senamhi-bolivia/AcroBoard_Station_GPRS_V04R04_XTAL/AcroBoard_Station_GPRS_V04R04_XTAL.kicad_pcb

## KiCad design AcroBoard_Station_GPRS_V04R04_XTAL.kicad_pcb (2019-05-08)

Schematic: AcroBoard_Station_GPRS_V04R04_XTAL.sch, AcroBoard Station v04 - electronic schematic

Parts:
C1, C2, C4, C7, C10, C11, C12, C14, C22, C25, C34, C77, C78, C79, C80, C81, C82: 100nF; C_0603
C3, C16, C17: 1uF; C_0805
C5, C6, C8, C9, C20, C23, C24, C28, C35, C36, C39, C43, C44, C47, C48, C59, C62: 100nF; C_0402_NoSilk
C13: 68uF; CP_Tantalum_Case-D_EIA-7343-31_Reflow
C15, C19, C21: 22pF; C_0402_NoSilk
C18: 68uF; CP_Elec_5x5.8
C26: 470uF; CP_Radial_D10.0mm_P5.00mm
C27: 22uF; C_0805
C29, C30: 1nF; C_0402
C31, C37, C49, C51: 7pF; C_0402_NoSilk
C32, C38, C40: 33pF; C_0402_NoSilk
C33, C45, C46, C52, C53, C63: 4.7uF; C_0805
C41, C42: 22uF; C_1210
C50: 10uF; C_0805
C54, C55, C65, C66: 22uF; C_1206
C56: 330uF; CP_Elec_10x10
C57, C64, C69: 6.8nF; C_0603
C58, C72: 10uF; C_1210
C60, C61, C70, C71, C74, C75: 0.1uF; C_0805
C67: 4.7uF; CP_Elec_4x5.8
C68: 1uF; C_1206
C73: 100uF; CP_Elec_6.3x7.7
C76: 10uF; C_1206
Cv1, Cv2, Cv3: 0.1uF; C_0805
Cvs1, Cvs2, Cvs3: 1uF; C_0805
D1: Blue; LED_0603
D2, D3, D19: Green; LED_0603
D4, D9, D11, D14: SMBJ26CA; D_SMB
D5, D6, D12, D15: 1N4148W-V; D_SOD-123
D7: BZX84C10; SOT-23
D8, D18: STPS2L40U; D_SMB
D10, D13, D16: BAT54JFILM; D_SOD-323
D17: STPS3L40SY; D_SMC
D20: Red; LED_0603
FP1: {55.0,-148.0}; Fiducial_1mm_Dia_2.54mm_Outer_CopperTop
FP2: {55.0,-30.0}; Fiducial_1mm_Dia_2.54mm_Outer_CopperTop
FP3: {125.0,-148.0}; Fiducial_1mm_Dia_2.54mm_Outer_CopperTop
FP4: {125.0,-30.0}; Fiducial_1mm_Dia_2.54mm_Outer_CopperTop
FP5: {84.6,-79.9}; Fiducial_1mm_Dia_2.54mm_Outer_CopperTop
FP6: {90.0,-115.0}; Fiducial_1mm_Dia_2.54mm_Outer_CopperTop
FP7: {116.0,-89.0}; Fiducial_1mm_Dia_2.54mm_Outer_CopperTop
J1: Conn_Coaxial; SMA_THT_Jack_Straight
J2: Conn_01x08; Molex_KK-6410-08_08x2.54mm_Straight
J3: Conn_01x05; Molex_KK-6410-05_05x2.54mm_Straight
J4, J5: CONN_01X10; Molex_KK-6410-10_10x2.54mm_Straight
J6: CONN_01X08; Molex_KK-6410-08_08x2.54mm_Straight
J7: CONN_01X05; Molex_KK-6410-05_05x2.54mm_Straight
L1, L2, L3: FERRITE-BEAD-220ohm; L_0805
L4: INDUCTOR-3.1uH; SER80xx
L5: 10uH; 7447779122
LG1: ACRONET; ACRONET_logo_090
LG2: OSHW; OSHW-Logo_7.5x8mm_SilkScreen
MH1, MH2, MH3, MH4: MH; MountingHole_320_500-NPTH
P1: CONN_02X06; Socket_Strip_Straight_2x06_Pitch2.54mm_SMD
P2: CONN_14X2; Socket_Strip_Straight_2x14_Pitch2.00mm
P3: 10k B=3.380; Measurement_Point_Round-TH_Small
P4: CONN_5X2; Socket_Strip_Straight_2x05_Pitch2.00mm
P5: CONN_5; BM05B-SRSS-TB
P6: CONN_3; Molex_KK-6410-03_03x2.54mm_Straight
Q4: Si2319CDS; SOT-23
Q5, Q9, Q10: BSS138; SOT-23
Q6, Q7, Q8: IRF9362; SOIC-8_3.9x4.9mm_Pitch1.27mm
R1, R2, R65, R66: 4k7; R_0603
R3, R4, R5, R56, R62, R63, R64, R67: 330R; R_0603
R6, R7, R8: 51R; R_0402
R9, R22, R45, R55, R68: 100K; R_0603
R10: 90k; R_0603
R11, R18, R19, R29, R54: 10K; R_0603
R12: 24K; R_0603
R13, R17, R71, R72, R73, R75, R76, R78: 1K; R_0603
R14: 180K; R_0603
R15: 698K; R_0603
R16, R51: 174K; R_0603
R20, R36, R39, R40, R46, R47: 1M; R_0603
R21, R44: 215K; R_0603
R23, R30: 1M02; R_0805
R24, R69: 48K7; R_0805
R25, R32: 76K8; R_0805
R26: 698K; R_0805
R27: 27K; R_0805
R28: 49K9; R_0805
R31: 36K5; R_0805
R33: 0R; R_0805
R34, R35, R49, R50, R53, R79, R80, R81, R82: 309K; R_0603
R37: 73.2K; R_0603
R38, R41, R48: 2k21; R_0603
R42, R43: 1k3; R_0805
R52: 4K7; R_0603
R57: 0R05; R_1206
R58, R61: 5K1; R_0603
R59, R60: 2k0; R_0805
R70, R74, R77: 5K6; R_0603
SW1: DTSM-32S-B
T1, T2, T3, T4, T5, T6, T7, T8, T9, T10: PDTC143XU; SOT-323_SC-70
U1, U2, U3: AT24CM01-SSHD-B; SOIC-8_3.9x4.9mm_Pitch1.27mm
U4: MB85RC1MTPNF-G-JNERE1; SOIC-8_3.9x4.9mm_Pitch1.27mm
U5, U6: SP336EEY-L; TSSOP-28_4.4x9.7mm_Pitch0.65mm
U7: 78723-1001
U8: ESDA6V1-5W6; SOT363_ESDA6V1-5W6
U9: NCP3170; SOIC-8_3.9x4.9mm_Pitch1.27mm
U10: TPS737; SOT-223-6
U11: ATXMEGA256A3U; TQFP-64_14x14mm_Pitch0.8mm
U13: SIM800C; SIMCom_SIM800C
U14: LTC4417IGN; SSOP-24_3.9x8.7mm_Pitch0.635mm
U15, U16, U21, U22: FPF2701MX; SOP-8_FPF2701MX
U17: LT3652EMSE; MSOP12_LT3652EMSE_HandSoldering
U18, U19: ACPL-M21L; SO-5_ACPL-M21L
U20: MIC1555; SOT-23-5
U23: PCA9517ADP; TSSOP-8_3x3mm_Pitch0.65mm
U24: MPL3115A2; LGA-8_3x5mm_Pitch1.25mm
U25: PCAL9554B; TSSOP-16_4.4x5mm_Pitch0.65mm
U26: PCAL9535APW; TSSOP-24_4.4x7.8mm_Pitch0.65mm
Y1: Crystal; Crystal_SMD_MicroCrystal_CC7V-T1A-2pin_3.2x1.5mm

Connections:
/ALT_CHARGE: J3.2, Q10.3 (D), R58.2
/BC_NC_FET: D7.1 (A), Q4.1 (G), R19.1, R22.2
/BC_NTC: P3.1, U17.8 (NTC)
/BC_Timer: C53.2, U17.6 (TIMER)
/BC_Vin: C56.1, C58.1, C59.1, D7.3 (K), D8.1 (K), D19.2 (A), D20.2 (A), J3.5, Q4.2 (S), R22.1, R36.2, R40.2, U17.1 (Vin)
/CLED_CMD: Q5.3 (D), Q10.1 (G), R37.1
/CMD_PSW1: R79.1, U16.4 (ON), U26.16 (P1_3)
/CMD_PSW2: R80.1, U15.4 (ON), U26.15 (P1_2)
/CMD_PSW3: R82.1, U22.4 (ON), U26.14 (P1_1)
/CMD_PSW4: R81.1, U21.4 (ON), U26.13 (P1_0)
/I2C_OUT_SCL: P4.3, U23.2 (SCLA)
/I2C_OUT_SDA: P4.1, U23.3 (SDAA)
/I2C_SIG: P4.7, T3.3 (C)
/I2C_VIN: C79.2, P4.5, U23.1 (VCCA)
/MCU_Status_LED: T1.1 (B), U11.26 (PD0)
/NETLIGHT: T9.1 (B), U13.41 (NETLIGHT)
/NValid1: U14.10 (~VALID1), U26.6 (P0_2)
/NValid2: U14.11 (~VALID2), U26.5 (P0_1)
/NValid3: U14.12 (~VALID3), U26.4 (P0_0)
/N_SHDN: R18.1, U14.2 (~SHDN)
/OC1: J7.2, R62.2
/OC2: J7.3, R63.2
/OC3: J7.4, R64.2
/OC4: J7.5, R67.2
/PA0: C34.1, P2.1, U11.62 (PA0)
/PA1: R10.2, R11.1, U11.63 (PA1)
/PA2: P2.3, U11.64 (PA2)
/PA3: P2.5, U11.1 (PA3)
/PA4: P2.7, U11.2 (PA4)
/PA5: P2.9, U11.3 (PA5)
/PA6: P2.11, U11.4 (PA6)
/PA7: P2.13, U11.5 (PA7)
/PB0: C35.1, P2.15, U11.6 (PB0)
/PB1: P2.17, U11.7 (PB1)
/PB2: P2.19, U11.8 (PB2)
/PB3: P2.21, U11.9 (PB3)
/PB4: P2.23, U11.10 (PB4)
/PB5: P2.25, U11.11 (PB5)
/PB6: P2.27, U11.12 (PB6)
/PB7: U11.13 (PB7), U23.5 (EN)
/PC0: R66.2, U11.16 (PC0), U23.6 (SDAB)
/PC1: R65.2, U11.17 (PC1), U23.7 (SCLB)
/PC2: U5.19 (R1_Out), U11.18 (PC2)
/PC3: U5.26 (TI_In), U11.19 (PC3)
/PC4: U5.27 (T2_In), U11.20 (PC4)
/PC5: U5.1 (T4_In), U11.21 (PC5)
/PC6: U5.21 (R3_Out), U11.22 (PC6)
/PC7: U5.28 (T3_In), U11.23 (PC7)
/PCAL_P3: T5.1 (B), U26.7 (P0_3)
/PCAL_P4: T6.1 (B), U26.8 (P0_4)
/PCAL_P5: T7.1 (B), U26.9 (P0_5)
/PCAL_P6: T8.1 (B), U26.10 (P0_6)
/PCAL_P7: T4.1 (B), U26.11 (P0_7)
/PD1: T3.1 (B), U11.27 (PD1)
/PD2: U6.19 (R1_Out), U11.28 (PD2)
/PD3: U6.26 (TI_In), U11.29 (PD3)
/PD4: U6.27 (T2_In), U11.30 (PD4)
/PD5: U6.1 (T4_In), U11.31 (PD5)
/PD6: U6.21 (R3_Out), U11.32 (PD6)
/PD7: U6.28 (T3_In), U11.33 (PD7)
/PDI_CLK: P1.4, R29.1, U11.57 (~RESET)
/PDI_DATA: P1.6, U11.56 (PDI)
/PE0: R1.2, U1.5 (SDA), U2.5 (SDA), U3.5 (SDA), U4.5 (SDA), U11.36 (PE0), U24.7 (SDL), U25.15 (SDA), U26.23 (SDA)
/PE1: R2.2, U1.6 (SCL), U2.6 (SCL), U3.6 (SCL), U4.6 (SCL), U11.37 (PE1), U24.8 (SCL), U25.14 (SCL), U26.22 (SCL)
/PF3: T2.1 (B), U11.49 (PF3)
/PF4: T10.1 (B), U11.50 (PF4)
/PF6: P1.10, U11.54 (PF6)
/PF7: P1.8, U11.55 (PF7)
/PG: R68.2, R69.1, U9.7 (PG), U10.5 (EN)
/PR0: U11.58 (PR0), U18.5 (VO)
/PR1: U11.59 (PR1), U19.5 (VO)
/PSW1: C61.1, J6.1, U16.8 (VOUT)
/PSW2: C60.1, J6.3, U15.8 (VOUT)
/PSW3: C75.1, J6.5, U22.8 (VOUT)
/PSW4: C74.1, J6.7, U21.8 (VOUT)
/PULSE1: P6.3, R43.1
/PULSE2: P6.1, R42.1
/PWRKEY: C24.1, T2.3 (C), U13.39 (~PWRKEY)
/Panel+: D4.1 (A1), D8.2 (A), J3.4, Q4.3 (D)
/RF_ANT: J1.1 (In), U13.32 (GSM_ANT)
/RING_TO_SIM: R71.1, U13.7 (UART1_RI)
/RX1: J4.2, U5.15 (R1_In)
/RX2: J4.3, U5.16 (R2_In)
/RX2_1: J5.2, U6.15 (R1_In)
/RX2_2: J5.3, U6.16 (R2_In)
/RX2_3: J5.7, U6.17 (R3_In)
/RX2_4: J5.8, U6.18 (R4_In)
/RX3: J4.7, U5.17 (R3_In)
/RX4: J4.8, U5.18 (R4_In)
/S900CTS: R72.2, U11.41 (PE5)
/S900RI: R71.2, U11.46 (PF0)
/S900STATUS: R78.1, U11.47 (PF1)
/SIMCTS_TO_SIM: R72.1, U13.4 (UART1_CTS)
/SIM_CLK: C19.1, R7.2, U13.16 (SIM_CLK)
/SIM_CLK_0: R7.1, U7.3 (CLK), U8.1 (I/O1)
/SIM_DATA: C15.1, R6.2, U13.15 (SIM_DATA)
/SIM_DATA_0: R6.1, U7.7 (I/O), U8.6 (I/O4)
/SIM_RST: C21.1, R8.1, U13.17 (SIM_RST)
/SIM_RST_0: R8.2, U7.2 (RST), U8.3 (I/O2)
/SIM_RXD: R76.1, R77.2, U13.2 (UART1_RXD)
/SIM_TXD: R75.1, U13.1 (UART1_TXD)
/SIM_USB_DM: P5.4, U13.26 (USB_DM)
/SIM_USB_DP: P5.3, U13.25 (USB_DP)
/SIM_USB_VBUS: P5.1, U13.24 (USB_VBUS)
/SIM_VDD: C23.1, U7.1 (Vcc), U8.4 (I/O3), U13.18 (SIM_VDD)
/SIM_VDDEXT: U13.40 (VDD_EXT)
/SP336_2_M0: U6.24 (MODE_0), U25.6 (P2)
/SP336_2_M1: U6.2 (MODE_1), U25.4 (P0)
/SP336_2_M2: U6.23 (MODE_2), U25.5 (P1)
/SP336_2_SLEW: U6.25 (SLEW), U25.7 (P3)
/SP336_M0: U5.24 (MODE_0), U25.10 (P5)
/SP336_M1: U5.2 (MODE_1), U25.12 (P7)
/SP336_M2: U5.23 (MODE_2), U25.11 (P6)
/SP336_SLEW: U5.25 (SLEW), U25.9 (P4)
/STATUS_PSW1: U16.7 (FLAGB), U26.20 (P1_7)
/STATUS_PSW2: U15.7 (FLAGB), U26.19 (P1_6)
/STATUS_PSW3: U22.7 (FLAGB), U26.18 (P1_5)
/STATUS_PSW4: U21.7 (FLAGB), U26.17 (P1_4)
/THR: C67.1, R47.2, U20.5 (THR)
/TOSC1: C49.1, U11.43 (TOSC1), Y1.1
/TOSC2: C51.1, U11.42 (TOSC2), Y1.2
/TRG: R45.2, T4.3 (C), U20.4 (TRG)
/TX1: J4.4, U5.6 (T1_Out)
/TX2: J4.5, U5.7 (T2_Out)
/TX2_1: J5.4, U6.6 (T1_Out)
/TX2_2: J5.5, U6.7 (T2_Out)
/TX2_3: J5.9, U6.4 (T3_Out)
/TX2_4: J5.10, U6.3 (T4_Out)
/TX3: J4.9, U5.4 (T3_Out)
/TX4: J4.10, U5.3 (T4_Out)
/VBAT: P1.12, U11.51 (VBAT)
/VPULSE1: R59.1, U19.1 (A)
/VPULSE2: R60.1, U18.1 (A)
/VPrimary: C72.1, C73.1, Cv2.1, D11.1 (A1), D18.2 (A), J2.2, Q7.7 (D1), Q7.8 (D1), R26.1, R39.2, R53.2, R57.1, U14.23 (V2), U17.9 (BAT)
/VRTC_SIM: C46.2, U13.28 (VRTC)
/Vbackup: Cv1.1, D14.1 (A1), J2.4, Q8.7 (D1), Q8.8 (D1), R30.1, U14.22 (V3)
/Vcc-3: C3.1, L1.2, U5.5 (VCC)
/Vcc-5: C16.1, L2.2, U6.5 (VCC)
/Vin_reg: D6.2 (A), R40.1, R44.1, U17.2 (Vin_reg)
/Vwall: Cv3.1, D9.1 (A1), J2.6, Q6.7 (D1), Q6.8 (D1), R23.1, U14.24 (V1)
/XMDTR: R13.2, U11.48 (PF2)
/XMDTR_TO_SIM: R13.1, R70.2, U13.6 (UART1_DTR)
/XMRTS: R73.2, U11.40 (PE4)
/XMRTS_TO_SIM: R73.1, R74.2, U13.3 (UART1_RTS)
/XMRXD-S900TXD: R75.2, U11.38 (PE2)
/XMTXD-S900RXD: R76.2, U11.39 (PE3)
/~BC_SHDN: R36.1, R37.2, U17.3 (~SHDN)
/~CHARGE: D5.2 (A), D12.2 (A), Q5.1 (G), R19.2, R39.1, U17.4 (~CHRG)
/~FAULT: J3.1, R61.2, U17.5 (~FAULT)
GND: C3.2, C4.1, C5.2, C6.2, C7.1, C8.2, C9.2, C10.2, C13.2, C14.2, C15.2, C16.2, C17.2, C18.2, C19.2, C20.2, C21.2, C22.1, C23.2, C24.2, C25.1, C26.2, C27.2, C28.2, C29.2, C30.1, C33.2, C34.2, C35.2, C36.2, C37.2, C38.2, C39.2, C41.2, C42.2, C43.2, C44.2, C45.1, C46.1, C47.2, C48.2, C49.2, C50.2, C51.2, C52.1, C53.1, C54.2, C55.2, C56.2, C58.2, C59.2, C60.2, C61.2, C62.2, C63.1, C65.2, C66.2, C67.2, C70.2, C71.2, C72.2, C73.2, C74.2, C75.2, C76.2, C77.2, C78.2, C79.1, C80.1, C81.1, C82.1, Cv1.2, Cv2.2, Cv3.2, Cvs1.2, Cvs2.2, Cvs3.2, D2.1 (K), D4.2 (A2), D9.2 (A2), D11.2 (A2), D14.2 (A2), D17.2 (A), J1.2 (Ext), J2.1, J2.3, J2.5, J2.7, J3.3, J4.1, J4.6, J5.1, J5.6, J6.2, J6.4, J6.6, J6.8, P1.1, P1.3, P1.5, P1.7, P1.9, P1.11, P2.2, P2.4, P2.6, P2.8, P2.10, P2.12, P2.14, P2.16, P2.18, P2.20, P2.22, P2.24, P2.26, P2.28, P4.2, P4.4, P4.6, P5.5, Q5.2 (S), Q9.2 (S), Q10.2 (S), R12.1, R16.2, R21.2, R25.2, R28.2, R32.2, R33.2, R34.1, R35.1, R44.2, R46.2, R49.1, R50.1, R54.2, R55.2, R69.2, R70.1, R74.1, R77.1, T1.2 (E), T2.2 (E), T3.2 (E), T4.2 (E), T5.2 (E), T6.2 (E), T7.2 (E), T8.2 (E), T9.2 (E), T10.2 (E), U1.4 (GND), U1.7 (WP), U2.2 (A1), U2.4 (GND), U2.7 (WP), U3.3 (A2), U3.4 (GND), U3.7 (WP), U4.2 (A1), U4.3 (A2), U4.4 (GND), U4.7 (WP), U5.8 (GND), U6.8 (GND), U7.5 (GND), U7.11 (GND1), U7.12 (GND2), U7.13 (GND3), U7.14 (GND4), U7.15 (GND5), U7.16 (GND6), U8.2 (GND), U9.1 (PGND), U9.3 (AGND), U10.3 (GND), U10.6 (GND), U11.14 (GND), U11.24 (GND), U11.34 (GND), U11.44 (GND), U11.52 (GND), U11.60 (GND), U13.8 (GND), U13.13 (GND), U13.19 (GND), U13.21 (GND), U13.27 (GND), U13.30 (GND), U13.31 (GND), U13.33 (GND), U13.36 (GND), U13.37 (GND), U14.13 (GND), U15.2 (PGOOD), U15.5 (GND), U16.2 (PGOOD), U16.5 (GND), U17.13 (GND), U18.4 (GND), U19.4 (GND), U20.2 (GND), U21.2 (PGOOD), U21.5 (GND), U22.2 (PGOOD), U22.5 (GND), U23.4 (GND), U24.3 (GND), U25.1 (A0), U25.2 (A1), U25.3 (A2), U25.8 (GND), U26.3 (A2), U26.12 (VSS), U26.21 (A0)
unnamed: C1.1, U5.12 (C1-)
unnamed: C1.2, U5.9 (C1+)
unnamed: C2.1, U5.13 (C2-)
unnamed: C2.2, U5.11 (C2+)
unnamed: C4.2, U5.14 (V-)
unnamed: C7.2, U5.10 (V+)
unnamed: C10.1, R3.1, R4.1, R5.2, SW1.2 (B)
unnamed: C11.1, U6.12 (C1-)
unnamed: C11.2, U6.9 (C1+)
unnamed: C12.1, U6.13 (C2-)
unnamed: C12.2, U6.11 (C2+)
unnamed: C22.2, U6.14 (V-)
unnamed: C25.2, U6.10 (V+)
unnamed: C31.1, C32.1, U9.5 (COMP)
unnamed: C31.2, C40.1, R14.2, R15.2, R16.1, U9.4 (FB1)
unnamed: C32.2, R14.1
unnamed: C39.1, L3.2, U11.61 (AVCC)
unnamed: C40.2, R17.1
unnamed: C52.2, D5.1 (K), D6.1 (K), R20.2
unnamed: C57.2, D10.1 (K), Q6.2 (G1), Q6.4 (G2), R38.1
unnamed: C63.2, D12.1 (K), D15.1 (K), R46.1
unnamed: C64.2, D13.1 (K), Q7.2 (G1), Q7.4 (G2), R41.1
unnamed: C68.1, D17.1 (K), L5.2, U17.12 (SW)
unnamed: C68.2, D18.1 (K), U17.11 (BOOST)
unnamed: C69.2, D16.1 (K), Q8.2 (G1), Q8.4 (G2), R48.1
unnamed: C78.1, U24.2 (CAP)
unnamed: Cvs1.1, Q6.1 (S1), Q6.3 (S2), U14.21 (VS1)
unnamed: Cvs2.1, Q7.1 (S1), Q7.3 (S2), U14.19 (VS2)
unnamed: Cvs3.1, Q8.1 (S1), Q8.3 (S2), U14.17 (VS3)
unnamed: D1.1 (K), T9.3 (C)
unnamed: D1.2 (A), R3.2
unnamed: D2.2 (A), R4.2
unnamed: D3.1 (K), T1.3 (C)
unnamed: D3.2 (A), R5.1
unnamed: D10.2 (A), R38.2, U14.20 (G1)
unnamed: D13.2 (A), R41.2, U14.18 (G2)
unnamed: D15.2 (A), R51.1, R53.1, R55.1
unnamed: D16.2 (A), R48.2, U14.16 (G3)
unnamed: D19.1 (K), R58.1
unnamed: D20.1 (K), R61.1
unnamed: J2.8, R18.2
unnamed: L4.1, U9.8 (VSW)
unnamed: L5.1, R57.2, U17.10 (SENSE)
unnamed: P6.2, R59.2, R60.2
unnamed: Q9.1 (G), R52.2, R54.1
unnamed: Q9.3 (D), R56.2
unnamed: R11.2, T10.3 (C)
unnamed: R20.1, R21.1
unnamed: R23.2, R24.1, U14.4 (UV1)
unnamed: R24.2, R25.1, U14.5 (OV1)
unnamed: R26.2, R27.1, U14.6 (UV2)
unnamed: R27.2, R28.1, U14.7 (OV2)
unnamed: R30.2, R31.1, U14.8 (UV3)
unnamed: R31.2, R32.1, U14.9 (OV3)
unnamed: R33.1, U14.3 (HYS)
unnamed: R34.2, U16.3 (ISET)
unnamed: R35.2, U15.3 (ISET)
unnamed: R42.2, U18.3 (C)
unnamed: R43.2, U19.3 (C)
unnamed: R47.1, R52.1, U20.3 (OUT)
unnamed: R49.2, U21.3 (ISET)
unnamed: R50.2, U22.3 (ISET)
unnamed: R51.2, U17.7 (Vfb)
unnamed: R62.1, T5.3 (C)
unnamed: R63.1, T6.3 (C)
unnamed: R64.1, T7.3 (C)
unnamed: R67.1, T8.3 (C)
unnamed: R78.2, U13.42 (STATUS)
SW3: C29.1, R9.2, R12.2, R56.1, U9.6 (EN)
V3.3: C5.1, C6.1, C8.1, C9.1, C33.1, C36.1, C43.1, C44.1, C45.2, C47.1, C48.1, C70.1, C71.1, C76.1, C77.1, C80.2, C81.2, C82.2, L1.1, L2.1, L3.1, P1.2, P4.9, R1.1, R2.1, R29.2, R65.1, R66.1, R79.2, R80.2, R81.2, R82.2, U1.2 (A1), U1.3 (A2), U1.8 (VCC), U2.3 (A2), U2.8 (VCC), U3.2 (A1), U3.8 (VCC), U4.8 (VCC), U10.2 (OUT), U11.15 (VDD), U11.25 (VDD), U11.35 (VCC), U11.45 (VCC), U11.53 (VCC), U18.6 (VDD), U19.6 (VDD), U23.8 (VCCB), U24.1 (Vdd), U24.4 (VDDIO), U25.16 (VDD), U26.2 (A1), U26.24 (VDD)
V4.0: C13.1, C14.1, C17.1, C18.1, C20.1, C37.1, C38.1, C41.1, C42.1, C50.1, L4.2, R15.1, R17.2, SW1.1 (A), U10.1 (IN), U13.34 (VBAT), U13.35 (VBAT)
VSelected: C26.1, C27.1, C28.1, C30.2, C54.1, C55.1, C57.1, C62.1, C64.1, C65.1, C66.1, C69.1, J7.1, P4.8, P4.10, Q6.5 (D2), Q6.6 (D2), Q7.5 (D2), Q7.6 (D2), Q8.5 (D2), Q8.6 (D2), R9.1, R10.1, R45.1, R68.1, U9.2 (VIN), U14.15 (VOUT), U15.1 (VIN), U16.1 (VIN), U20.1 (VS), U21.1 (VIN), U22.1 (VIN)

Notes on the sheet:
GND
RS485/RS232 Transceiver
Mounting Holes
Board Connector 5
3V3
GPRS Debug Connector
USB_DM
USB_DP
P2out
Board Connector 4
PF7
PF6
2V8
VBAT
PA5
PA6
PA7
PB0
PB1
PB2
PB3
PB4
PB5
Board Connector 3
GPRS Switch
Pulse Signal Stage
VPin
P1out
Board Connector 1
Pulse Signal Connector
Battery Voltmeter
Status LED Module
XMEGA MCU
I2C EEPROM Memory Module
MCU Status LED
Power ON LED
AcroBoard Station v03 r02 Released under the Creative Commons Attribution Share-Alike 4.0 Unported license (http://creativecommons.org/licenses/by-sa/4.0/) and the Open Source Hardware (OSHW) Definition 1.0 (http://freedomdefined.org/OSHW) Designed by ACRONET® 2016 (http://www.acronet.cc)
Logos
PA4
THIS ELECTRONIC SCHEMATIC IS PROVIDED "AS IS" AND "WITH ALL FAULTS". ACRONET® DISCLAIMS ALL OTHER WARRANTIES, EXPRESS OR IMPLIED, REGARDING PRODUCTS, INCLUDING BUT NOT LIMITED TO, ANY IMPLIED WARRANTIES OF MERCHANTABILITY OR FITNESS FOR A PARTICULAR PURPOSE.
SIM900 Status LED
DATA
CLK
XX = component to be chosen NM = not mounted component NCMP = virtual component
Capacitor C52/C152, respectively, may be mounted with the following footprints: - TantalC_SizeD_EIA-7343 - c_elec_5x5.8 C152 is used instead of C52 for this release!
STATUS OUTPUT
SOLAR PANEL INPUT
BATTERY (Primary)
Fiducial Points
Legend
PCAL9555A has internal PullUP/PullDOWN resistors
PB6
Board Reboot
Battery Charger as described in LTJournal V23N3
I2C GPIO Extenders
Power Selector
MCU module
To improve performances an FERAM chip is used
I2C Signal
USB_VBUS
PA3
PA2
PA0
Board Power
MCU Power

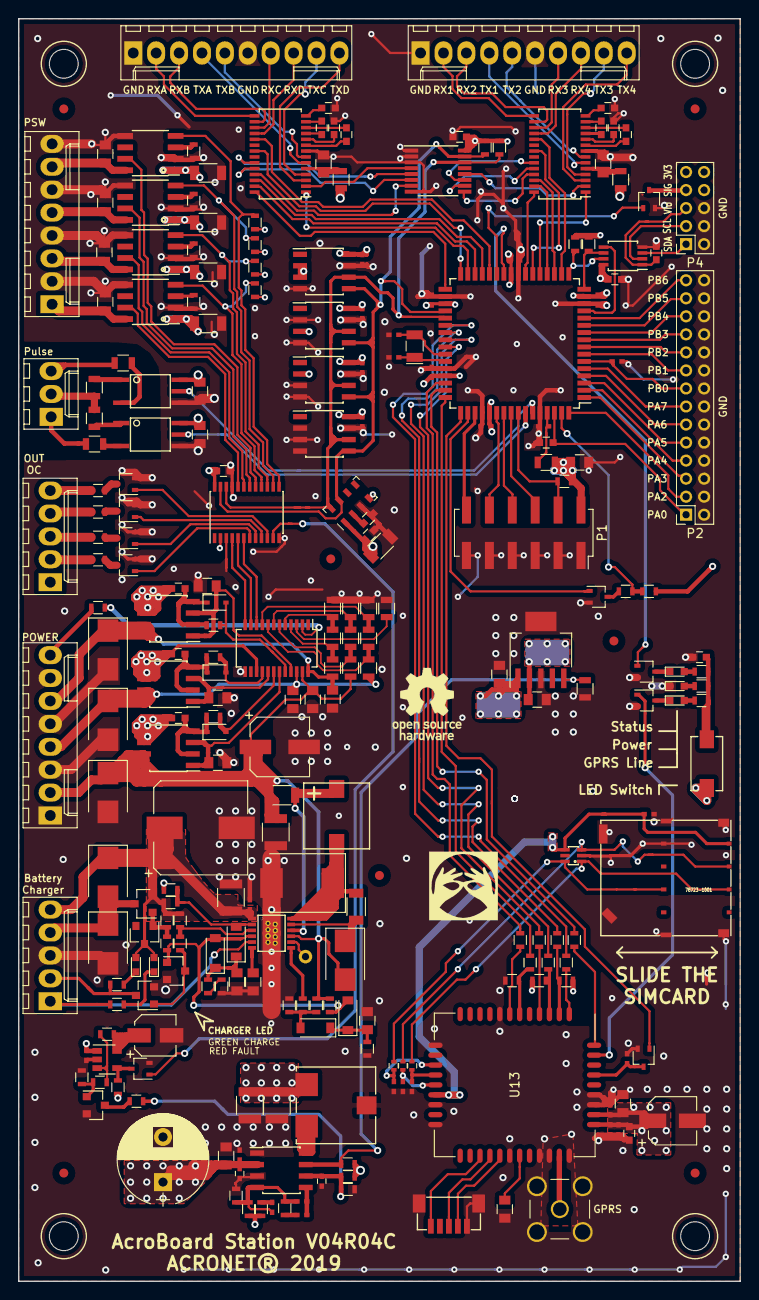
[picture p1: board AcroBoard_Station_GPRS_V04R04_XTAL.kicad_pcb from above]

Board: 4 copper layers, 80.0 x 140.0 mm, 264 parts (0 on the bottom side), 221 nets.
